jaebin401/TILT-mk.2/tools/servo_tool_UART/README.md

# TILT 서보 셋업 / 캘리브레이션 툴

`tilt_config.h` 의 TODO 항목을 실측으로 채우는 도구. 모든 결과는 **그대로 붙여넣을 수 있는 C 코드**로 출력된다.

다루는 관절은 `tilt_config.h` 의 8개: 다리당 Hip Roll / Hip Pitch / Knee Pitch / **Ankle Pitch**
(ID 11–14 = 왼다리, 21–24 = 오른다리). 배열 순서는 `LHR LHP LKP LAP | RHR RHP RKP RAP`.

| config 항목 | 채우는 툴 |
|---|---|
| `SERVO_ID[]` | `i` ID 변경 후 출력 안내에 맞춰 반영 |
| `ZERO_TICK[]` | 다리 6관절: `j` 정밀 조그 → `z` / 발목 2관절: `k` 발목 영점 → `j` 조그 → `n` |
| `JOINT_SIGN[]` | `s` 회전 부호 판별 |
| `JOINT_LIMIT[2][4]` | `l` 관절 제한 지정 (관절별 수동, Enter + y/n) |
| `SERVO_UART_BAUD` | `b` 보레이트 스캔 |

## 위치

```
TILT mk.2/
├── firmware/
│   └── components/
│       ├── tilt_config/
│       └── tilt_sts3215/
└── tools/
    └── servo_tool_UART/     ← 이 프로젝트
```

루트 `CMakeLists.txt` 의 `EXTRA_COMPONENT_DIRS` 가
`../../firmware/components` 를 가리키므로, 이 디렉토리에서 바로 빌드하면
공용 컴포넌트가 딸려 온다.

## 빌드

```bash
cd tools/servo_tool_UART
idf.py set-target esp32s3
idf.py -p /dev/tty.usbmodemXXXX flash monitor
```

`Ctrl + ]` 로 모니터 종료.

## tilt_sts3215 연결 방식

```cpp
tilt::sts3215::Sts3215Bus bus{config};
bus.initialize();
bus.ping(id);
bus.readPosition(id, tick);
bus.writePosition(id, tick, speed);
bus.setTorque(id, enabled);
bus.setBaudRate(baud);
```

`main.cpp` 상단의 얇은 래퍼가 기존 도구 호출을 이 실제 API로 연결한다.

## 저장 정책

**진실 공급원은 `tilt_config.h` 하나뿐이다.**

NVS 는 캘리브레이션 도중 리셋·정전으로 작업이 날아가지 않게 하는 임시 스크래치일 뿐이다.
부팅 시에는 **항상 config 값**을 쓴다. config 와 다른 스크래치가 있으면 그 사실만 알리고,
이어서 작업하려면 `r` 로 불러온다. (`h` / `u` 이동은 스크래치를 불러와도 항상 config 기준)

캘리브레이션이 끝나면:
1. 출력된 배열을 `tilt_config.h` 에 붙여넣고
2. `c` 로 NVS 스크래치를 비운다

이 두 단계를 하지 않으면 "코드에 적힌 값"과 "로봇이 실제로 쓰는 값"이 갈라진다.

## 영점 잡는 순서

1. **`i` ID 변경** — 서보를 반드시 한 개만 연결하고 목표 ID로 변경한 뒤 `SERVO_ID[]`에 반영
   - `p` ID 스캔이 끝에 config 의 8개 ID 중 응답 없는 것을 따로 알려준다
2. **`s` 부호 판별** — 먼저 해야 조그 화면의 DH theta 부호가 맞게 나온다 (발목 포함 8관절)
3. **`o` 엔코더 모니터** — 토크를 풀고 손으로 대략 다리 편 자세를 만든 뒤 `z` (다리 6관절만)
4. **`j` 정밀 조그** — FINE(1 tick = 0.088deg)로 마무리, DH theta 가 0.00 에 수렴하면 `z`
5. **`k` 발목 영점** — hip/knee 를 zero pose 로 세우고 발목만 토크를 푼 뒤, 몸통을 잡고 평평한 바닥에
   발바닥을 붙여 `z`. 발목은 그 위치에서 다시 토크 ON
6. **`j` 정밀 조그(발목)** — `u/j`(왼), `o/l`(오른)로 발바닥 평행을 마무리하고 `n`
7. 출력된 `ZERO_TICK` 을 `tilt_config.h` 에 붙여넣고 다시 빌드·플래시
8. **`h` HOME 이동** — config 영점으로 전 관절을 0° 로 이동, 다리가 곧게 펴졌는지 확인
9. **`u` zero pose 이동** — config 의 `[0, -20, +40, -20]` 으로 이동해 검증
   - 발판이 지면과 평행한가
   - 발바닥 점이 hip pitch 축 바로 아래(x≈0)인가
   - 지면 ~ hip pitch 축 높이가 약 137mm 인가 (`ZERO_POSE_HEIGHT_MM`)
10. **`l` 관절 제한 지정** — 마지막에. 영점이 확정돼야 각도 값이 의미를 가진다

`h` / `u` 는 pose_test 의 `h` / `s` 와 같은 방식이다: 8관절 위치를 모두 읽어 goal 로 기록 → 토크 ON →
rad 공간 smoothstep 보간을 10 ms 마다 sync write. 부팅 시 가속도 레지스터도 pose_test 처럼 0 으로 쓴다.
도착 후
도착 후 관절별 목표·실측·오차 표를 출력한다. 목표는 작업값이 아니라 **`tilt_config.h` 의 ZERO_TICK / JOINT_SIGN** 으로 계산한다.

## 관절 제한 지정 (`l`)

관절 하나씩 순서대로 (LHR → LHP → LKP → LAP → RHR → … → RAP):

1. 최소(−)쪽 끝까지 움직인다 — `+` / `-` 키(스텝 `m`: 1° → 5° → 0.2°), 또는 `f` 로 그 관절만 토크를 풀고 손으로
2. `Enter` → `y/n` 으로 그 각도(서보 실측)를 최소 한계로 확정
3. 최대(+)쪽도 같은 방식으로 확정
4. 그 관절은 0° 로 돌아가고 다음 관절로 넘어간다

| 키 | 기능 |
|---|---|
| `+` / `-` | 이 관절을 DH +/- 방향으로 한 스텝 |
| `m` | 스텝 1° → 5° → 0.2° |
| `f` | 이 관절만 토크 OFF/ON |
| `Enter` | 지금 각도를 확정 (y/n) |
| `>` / `<` | 이 쪽은 기존 값 유지하고 다음 / 이전 관절로 |
| `x` | 종료하고 `JOINT_LIMIT` 출력 |

확정하지 않은 쪽은 config 값을 그대로 유지하며, 출력 주석에 `실측` / `기존` 으로 표시된다.
최소가 0° 보다 크거나 최대가 0° 보다 작으면 부호 문제일 수 있어 경고를 띄운다.

## 서보 ID 변경

`i`를 누르면 현재 ID와 새 ID를 입력받아 STS3215 EEPROM의 ID를 변경한다.

1. 외부 서보 전원을 끈다.
2. 변경할 STS3215 **한 개만** UART 버스에 연결한다.
3. 전원을 켜고 `p`로 현재 ID를 확인한다.
4. `i`를 누르고 현재 ID와 사용하지 않은 새 ID를 입력한다.
5. 성공 메시지를 확인한 뒤 서보와 케이블에 새 ID를 표시한다.
6. `tilt_config.h`의 `SERVO_ID[]`도 같은 값으로 수정한다.

툴은 새 ID가 이미 응답하면 변경을 거부한다. 변경 시 토크를 끄고 EEPROM 잠금을
해제한 뒤 ID를 기록하며, 새 ID로 EEPROM을 다시 잠그고 이전/새 ID 응답까지 검증한다.
같은 현재 ID를 가진 서보가 여러 개 연결돼 있으면 모두 함께 바뀔 수 있으므로 단일 연결
규칙을 반드시 지켜야 한다.

### 각 관절의 DH theta = 0 자세

| 관절 | 영점 자세 |
|---|---|
| Hip Roll | 다리가 좌우로 기울지 않고 수직 |
| Hip Pitch | 허벅지가 수직 |
| Knee Pitch | 정강이가 허벅지와 일직선 |
| Ankle Pitch | 발바닥이 정강이와 직각 (다리를 편 HOME 에서 발바닥이 바닥과 평행) |

`zero pose` 인 `[0, -20, +40, -20]` 과 혼동하지 말 것. 영점은 **DH theta = 0** 인 자세(다리를 쭉 펴고 발바닥 평행)이고,
zero pose 는 거기서 허벅지를 20° 앞으로, 정강이를 20° 뒤로 기울이고(무릎 +40°) 발목 −20° 로 발바닥을 지면과
평행하게 맞춘 **운용 기본자세**다. 발바닥 평행 조건은 `hip + knee + ankle = 0`.
`k` 발목 영점은 zero pose 에서 발바닥을 바닥에 붙여 잡으므로 이 정의와 맞는다 (ankle = `ZERO_POSE_RAD` 의 −20° 로 역산).

### DH + 방향

| 관절 | + 방향 |
|---|---|
| Hip Roll | 발이 로봇의 왼쪽(+y)으로 (왼다리=벌림, 오른다리=모음) |
| Hip Pitch | 다리가 뒤로 스윙 |
| Knee Pitch | 무릎이 굽음 |
| Ankle Pitch | 발끝이 내려감 (toes down) |

좌우 다리 모두 같은 정의를 쓴다(로봇 시선 기준 오른손 회전 규칙). 거울 반전은 `JOINT_SIGN` 이 흡수한다.

## 안전

- 서보 전원은 손 닿는 곳에 두고, 언제든 끌 수 있게 한다
- `space` = 전체 토크 OFF (어느 화면에서든)
- 부팅 시 절대 위치 명령을 보내지 않는다 — 현재 위치를 READ 해서 goal 로 먼저 기록한 뒤 토크를 켠다
- 토크를 켜는 모든 경로(`j`, `s`, `0`, `t`, 부팅)는 같은 순서를 따른다. 위치 읽기가 실패하면 토크를 켜지 않는다
- `s` 부호 판별과 `h` / `u` 이동, `l` 관절 제한 지정은 **공중에 매단 상태**에서 할 것
- `0` 은 영점(`ZERO_TICK`)을 확정한 뒤에만 실행할 것. placeholder(2048) 상태에서는 엉뚱한 자세로 움직인다
- `l` 관절 제한은 다리끼리 부딪히기 직전까지만. 키로 밀다가 서보가 걸려 버티면 바로 반대 키로 물러날 것. 특히 Hip Roll 안쪽(모음) 방향은 다리끼리 충돌하기 쉽다
- `k` 는 발목 토크를 푼다 — 로봇이 발목으로 서 있지 못하니 몸통을 반드시 잡고 할 것
- NVS 스크래치 키가 8관절 형식(`zero_tick8`, `joint_sign8`)으로 바뀌어, 이전 6관절 스크래치는 읽지 않는다

## 툴 목록

| 키 | 기능 |
|---|---|
| `p` | ID 스캔 (0~253) + config 8개 ID 응답 확인 |
| `i` | 서보 ID 변경 (한 번에 한 개만 연결, EEPROM 재잠금·응답 검증) |
| `b` | 보레이트 스캔 |
| `j` | 정밀 조그 (q/a w/s e/d u/j = 왼쪽 ROLL/PITCH/KNEE/ANKLE, r/f t/g y/h o/l = 오른쪽, `m` 스텝 토글, `i` 상태표, `z` 다리 영점, `n` 발목 영점) |
| `o` | 토크 해제 + 엔코더 실시간 모니터 (`z` 다리 영점, `n` 발목 영점) |
| `k` | 발목 영점: zero pose 로 세우고 발목만 토크 OFF → 발바닥을 바닥에 붙여 `z` |
| `l` | 관절 제한 지정 (관절별 수동, Enter + y/n) → `JOINT_LIMIT` 출력 |
| `s` | 회전 부호 판별 → `JOINT_SIGN` 출력 |
| `h` (또는 `0`) | HOME — 전 관절 0° 로 이동 (pose_test `h` 와 같은 방식, config 기준, 2초 + 오차표) |
| `u` | STAND — zero pose [0, -20, +40, -20] 으로 이동 (config 기준, 2초 + 오차표) |
| `v` | 현재 작업값 배열 전부 출력 (영점·부호·제한) |
| `r` | NVS 스크래치를 작업값으로 불러오기 |
| `c` | NVS 스크래치 비우기 |
| `t` | 전체 토크 ON/OFF 토글 |
| `?` | 메뉴 |
| `space` | 비상정지 |
