jaebin401/TILT-mk.2/model/meshes/assembly_1_collision.stl

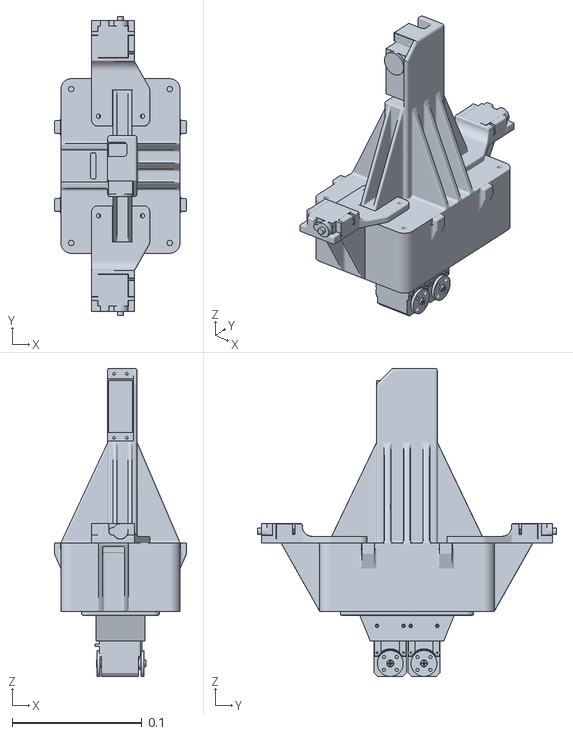
[picture p1: CAD file, 2026-10-07]
model/meshes/assembly_1_collision.stl
0.102 x 0.231 x 0.238
