jaebin401/TILT-mk.2/model/meshes/arm_r_assembly_visual.stl

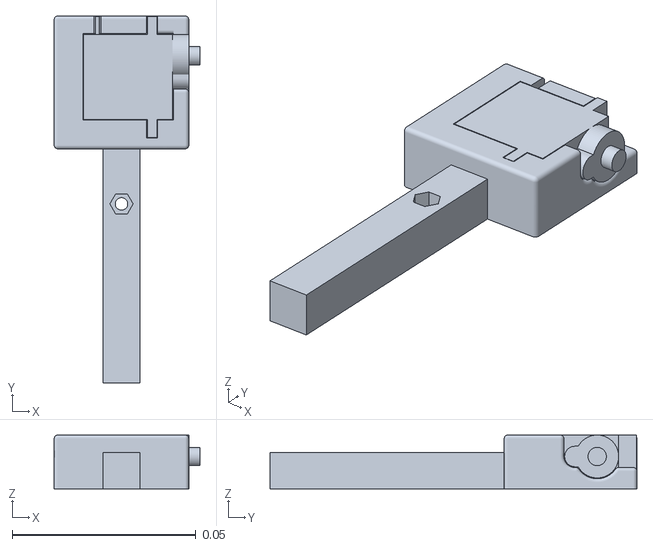
[picture p2: CAD file, 2026-10-07]
model/meshes/arm_r_assembly_visual.stl
0.0397 x 0.1 x 0.0147
