jaebin401/TILT-mk.2/model/meshes/assembly_1_2_visual.stl

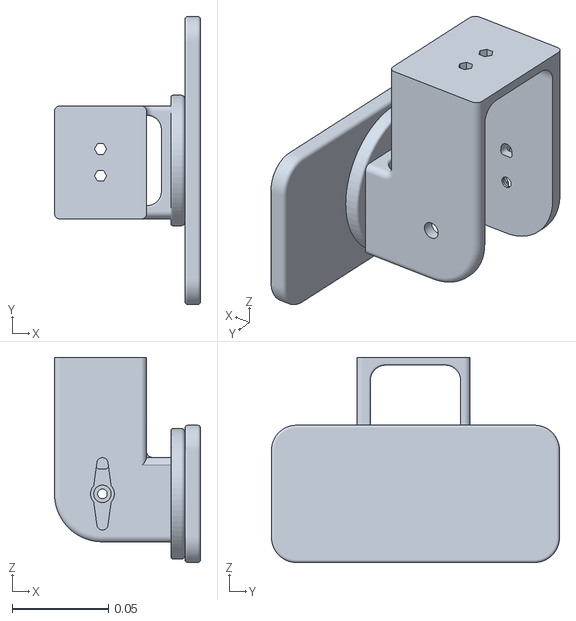
[picture p3: CAD file, 2026-10-07]
model/meshes/assembly_1_2_visual.stl
0.0761 x 0.15 x 0.107
