jaebin401/TILT-mk.2/CAD/TILT mk.2 step files/arm/arm R v2.step

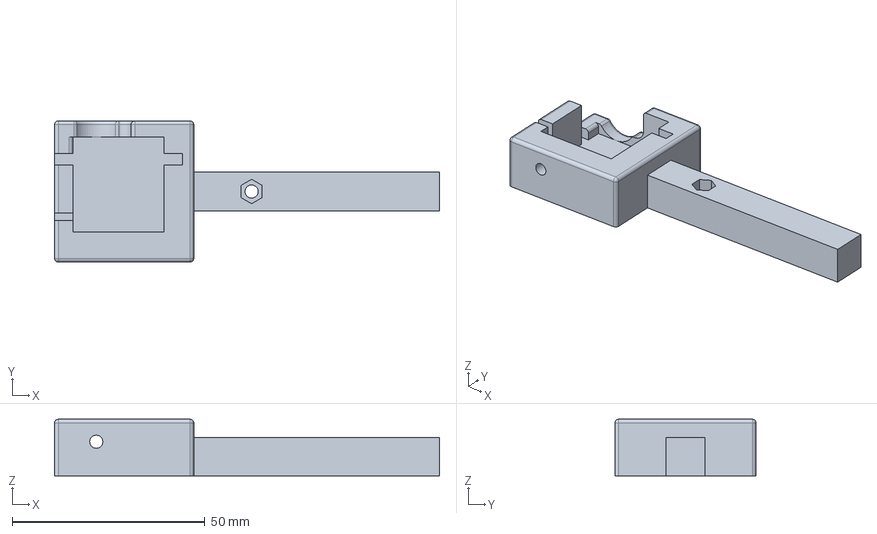
[picture p4: CAD file, 2026-10-07]
CAD/TILT mk.2 step files/arm/arm R v2.step
100.0 x 36.7 x 14.7 mm
