jaebin401/TILT-mk.2/CAD/TILT mk.2 step files/head/ear.step

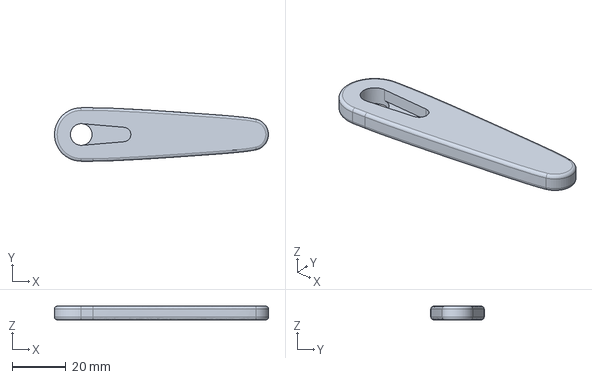
[picture p5: CAD file, 2026-10-07]
CAD/TILT mk.2 step files/head/ear.step
80.0 x 20.0 x 5.10 mm
