jaebin401/TILT-mk.2/CAD/TILT mk.2 step files/leg/hip pitch mount.step

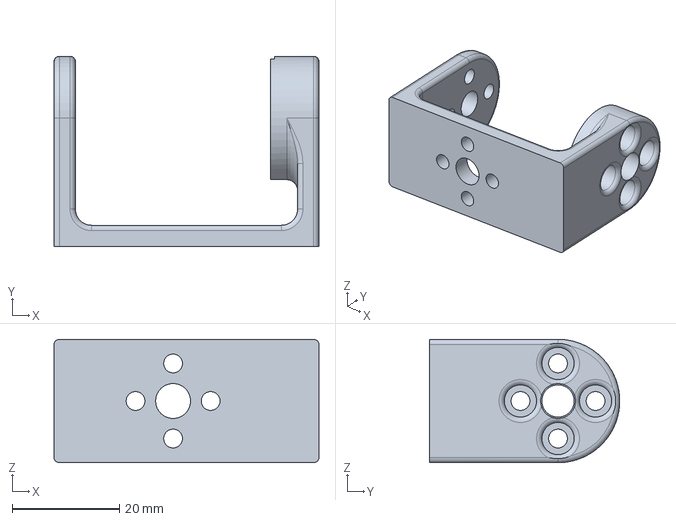
[picture p6: CAD file, 2026-10-07]
CAD/TILT mk.2 step files/leg/hip pitch mount.step
49.4 x 35.5 x 23.0 mm
