jaebin401/TILT-mk.2/CAD/TILT mk.2 step files/torso/torso v2.step

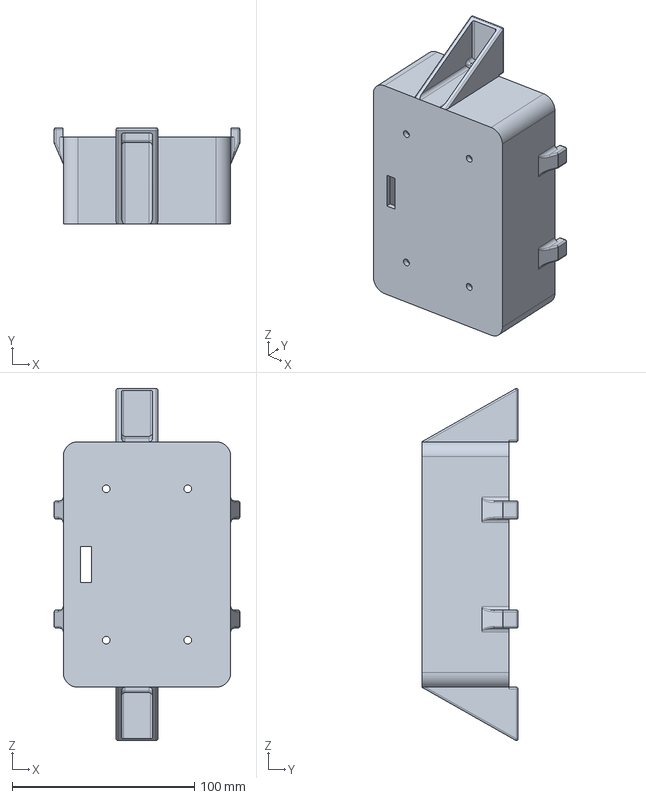
[picture p7: CAD file, 2026-10-07]
CAD/TILT mk.2 step files/torso/torso v2.step
102.0 x 53.0 x 193.4 mm
