jaebin401/TILT-mk.2/CAD/TILT mk.2 step files/arm/our sg90.step

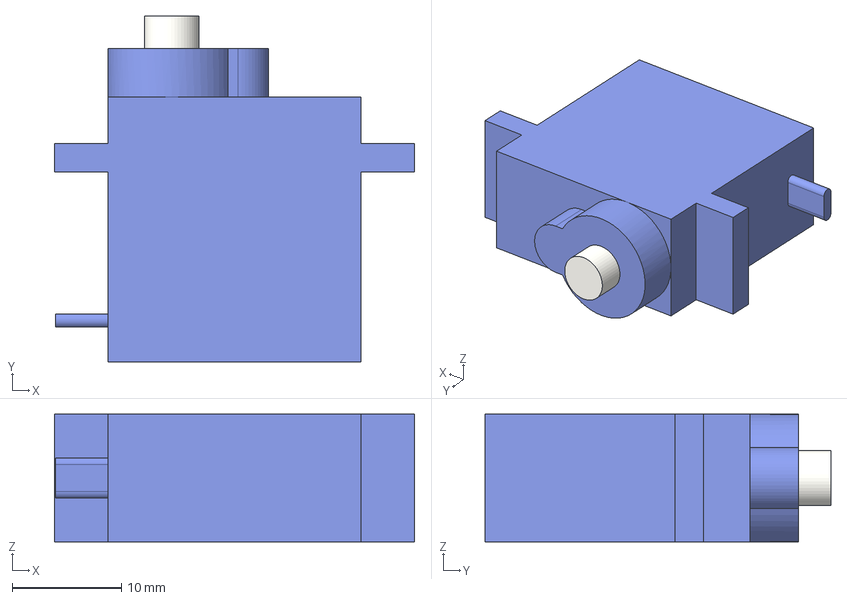
[picture p8: CAD file, 2026-10-07]
CAD/TILT mk.2 step files/arm/our sg90.step
33.0 x 31.7 x 11.7 mm
