jaebin401/TILT-mk.2/CAD/TILT mk.2 step files/head/iPhone 17.step

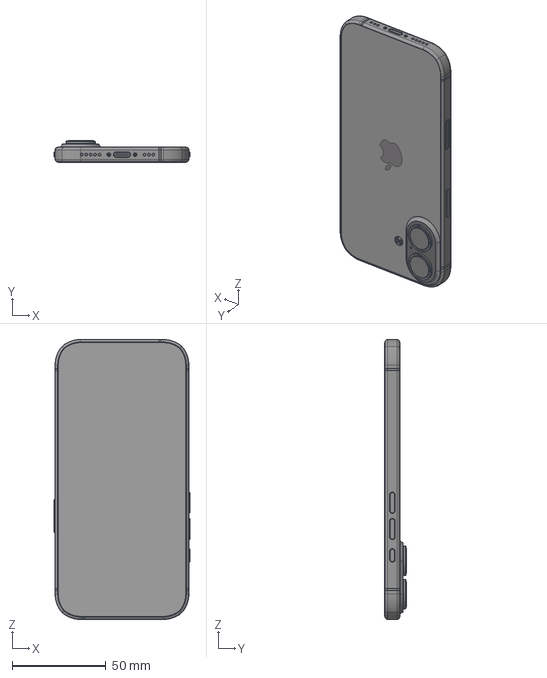
[picture p9: CAD file, 2026-10-07]
CAD/TILT mk.2 step files/head/iPhone 17.step
72.5 x 11.5 x 149.6 mm
