jaebin401/TILT-mk.2/CAD/TILT mk.2 step files/leg/foot.step

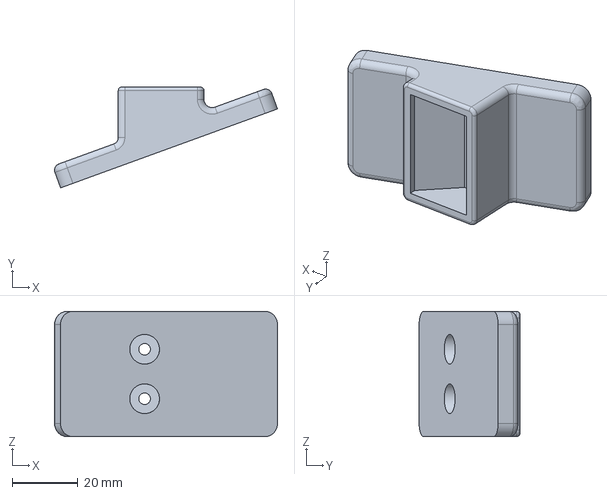
[picture p10: CAD file, 2026-10-07]
CAD/TILT mk.2 step files/leg/foot.step
67.6 x 30.5 x 38.0 mm
