jaebin401/TILT-mk.2/CAD/TILT mk.2 step files/torso/torso lid v.2.step

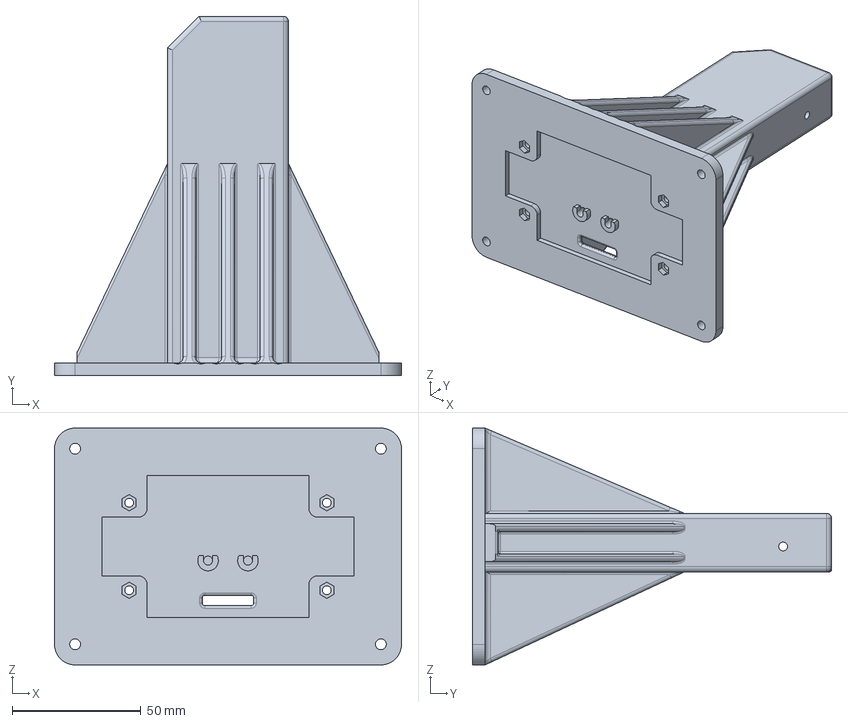
[picture p11: CAD file, 2026-10-07]
CAD/TILT mk.2 step files/torso/torso lid v.2.step
134.8 x 139.7 x 92.0 mm
