jaebin401/TILT-mk.2/CAD/TILT mk.2 step files/arm/shoulder v2.step

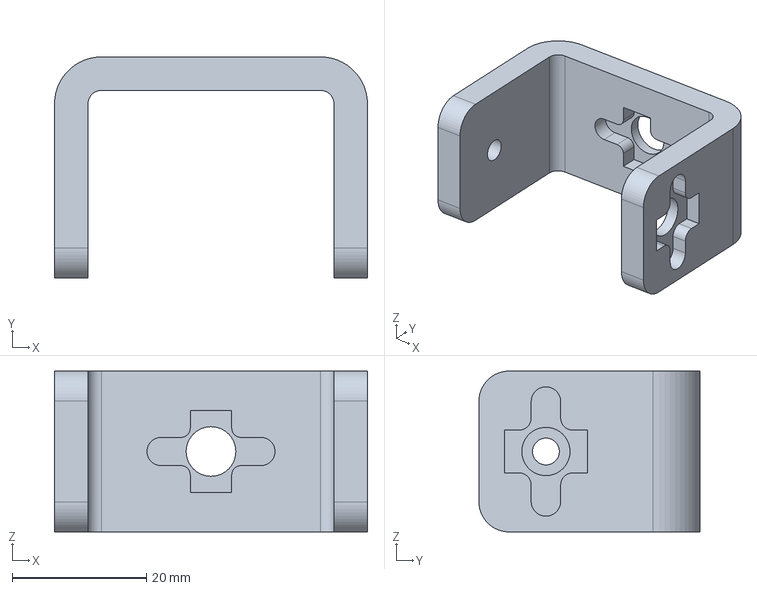
[picture p12: CAD file, 2026-10-07]
CAD/TILT mk.2 step files/arm/shoulder v2.step
46.7 x 33.0 x 24.0 mm
