jaebin401/TILT-mk.2/CAD/TILT mk.2 step files/head/magsafe mount.step

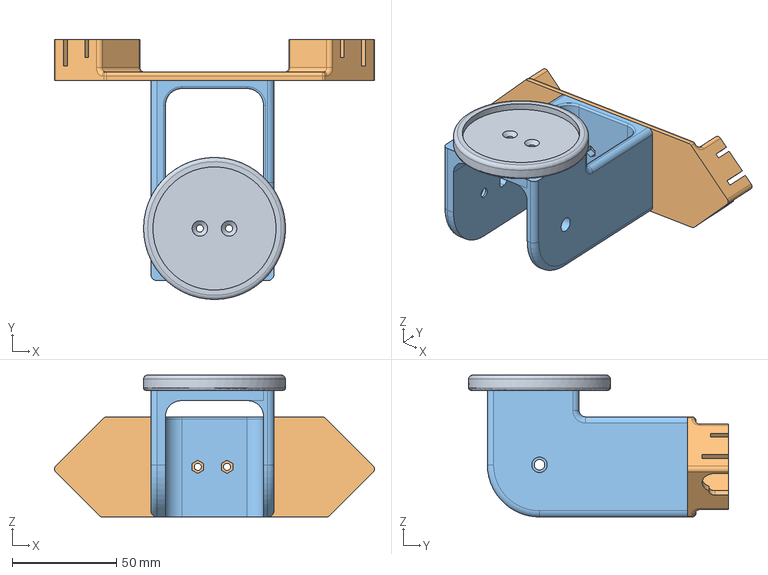
[picture p13: CAD file, 2026-10-07]
CAD/TILT mk.2 step files/head/magsafe mount.step
153.3 x 124.5 x 68.0 mm
