jaebin401/TILT-mk.2/CAD/TILT mk.2 step files/leg/thigh.step

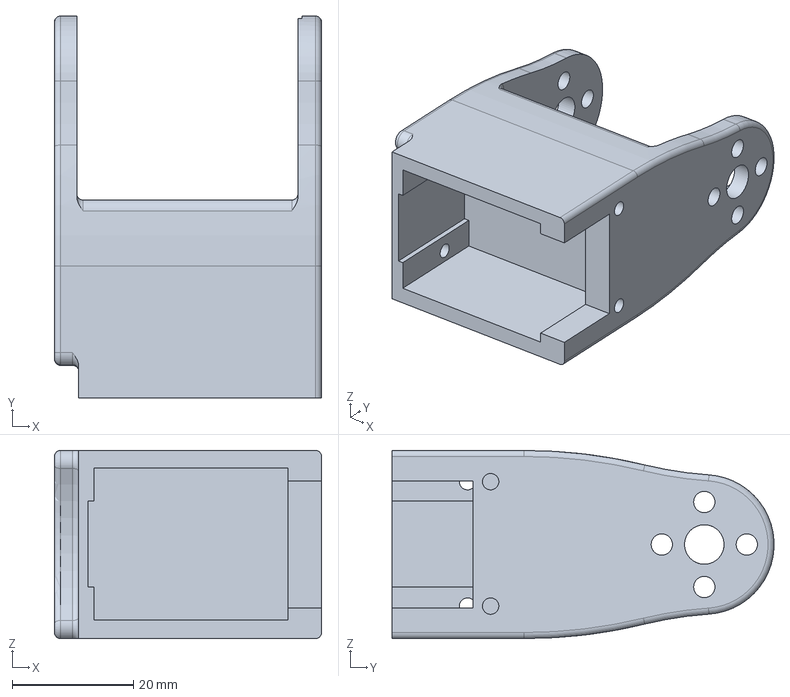
[picture p14: CAD file, 2026-10-07]
CAD/TILT mk.2 step files/leg/thigh.step
44.0 x 62.9 x 31.0 mm
