jaebin401/TILT-mk.2/CAD/TILT mk.2 step files/torso/MG996R.step

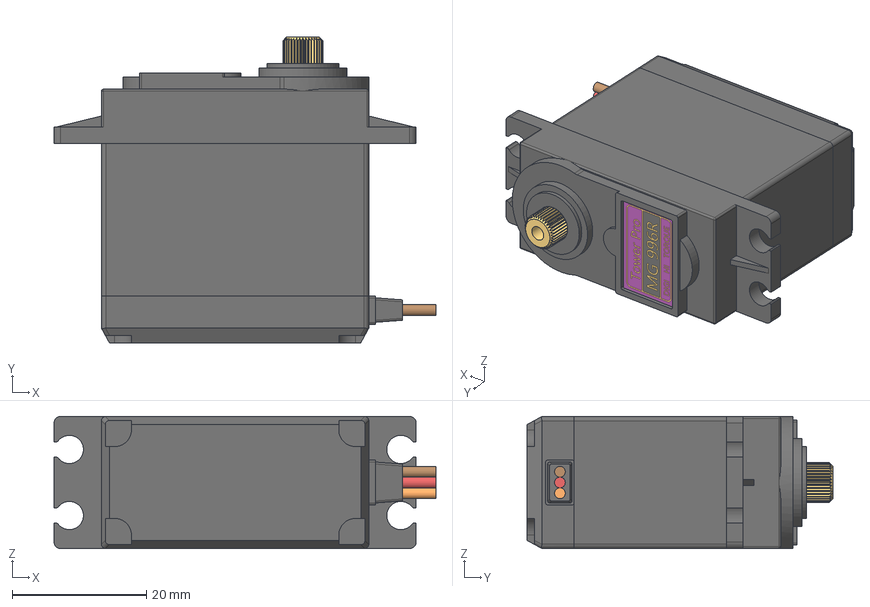
[picture p15: CAD file, 2026-10-07]
CAD/TILT mk.2 step files/torso/MG996R.step
57.0 x 45.5 x 19.7 mm
servoMotorMG996R
servoMotorMG996R (1)
servoMotorMG996R (2)
servoMotorMG996R (3)
servoMotorMG996R (4)
servoMotorMG996R (5)
servoMotorMG996R (6)
servoMotorMG996R (7)
attachmentCircular
attachmentCircular (1)
attachmentCross
attachmentStar
attachmentStraight
