jaebin401/TILT-mk.2/CAD/TILT mk.2 step files/arm/arm mount R v2.step

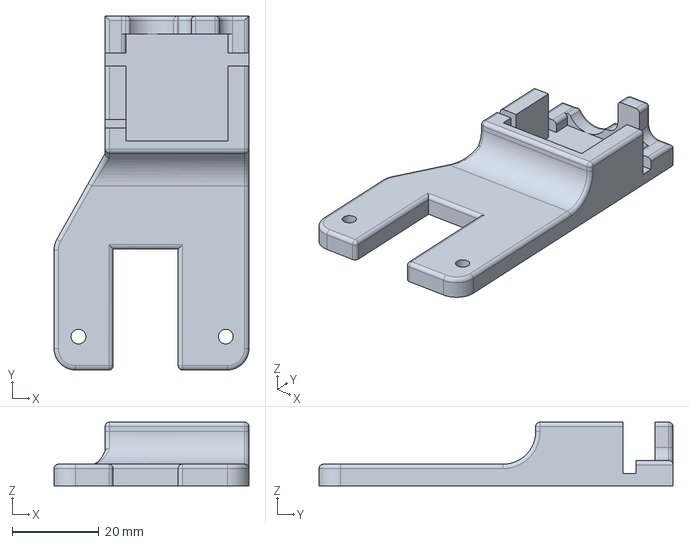
[picture p16: CAD file, 2026-10-07]
CAD/TILT mk.2 step files/arm/arm mount R v2.step
45.0 x 81.7 x 14.7 mm
