jaebin401/TILT-mk.2/CAD/TILT mk.2 step files/leg/calf L.step

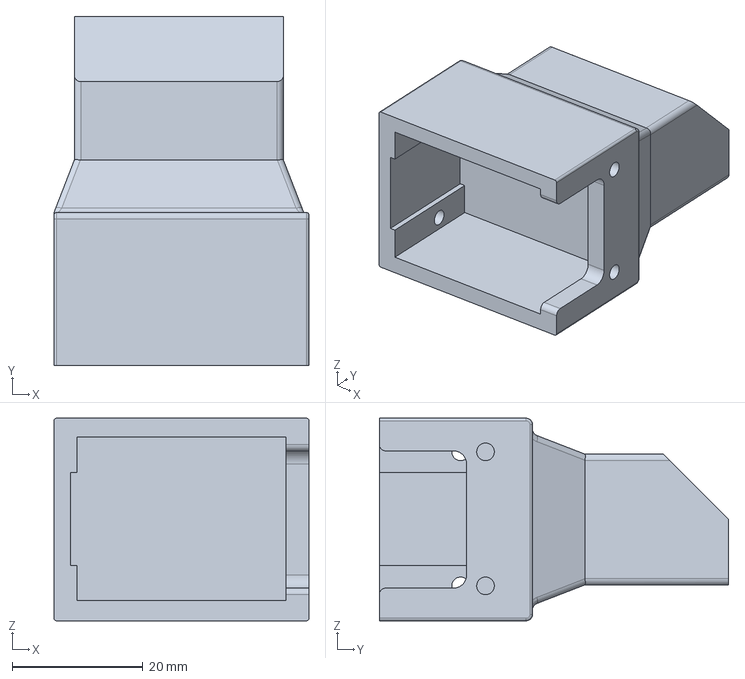
[picture p17: CAD file, 2026-10-07]
CAD/TILT mk.2 step files/leg/calf L.step
39.0 x 53.4 x 31.0 mm
