jaebin401/TILT-mk.2/CAD/TILT mk.2 step files/leg/hip roll mount.step

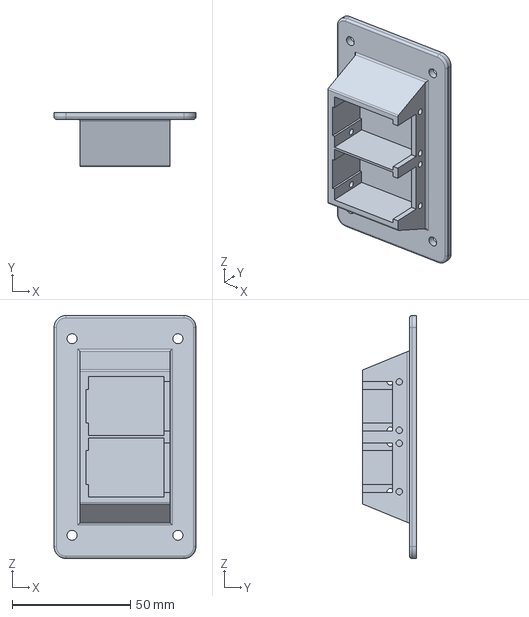
[picture p18: CAD file, 2026-10-07]
CAD/TILT mk.2 step files/leg/hip roll mount.step
60.0 x 23.0 x 102.8 mm
