jaebin401/TILT-mk.2/model/meshes/calf_r_collision.stl

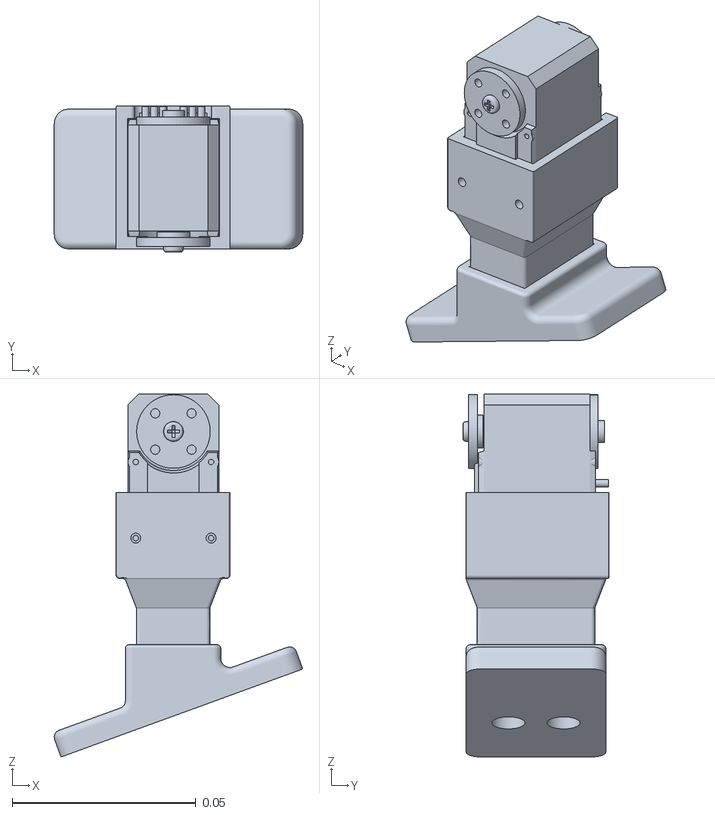
[picture p19: CAD file, 2026-10-07]
model/meshes/calf_r_collision.stl
0.0676 x 0.0398 x 0.0987
