jaebin401/TILT-mk.2/CAD/TILT mk.2 step files/leg/STS3215.step

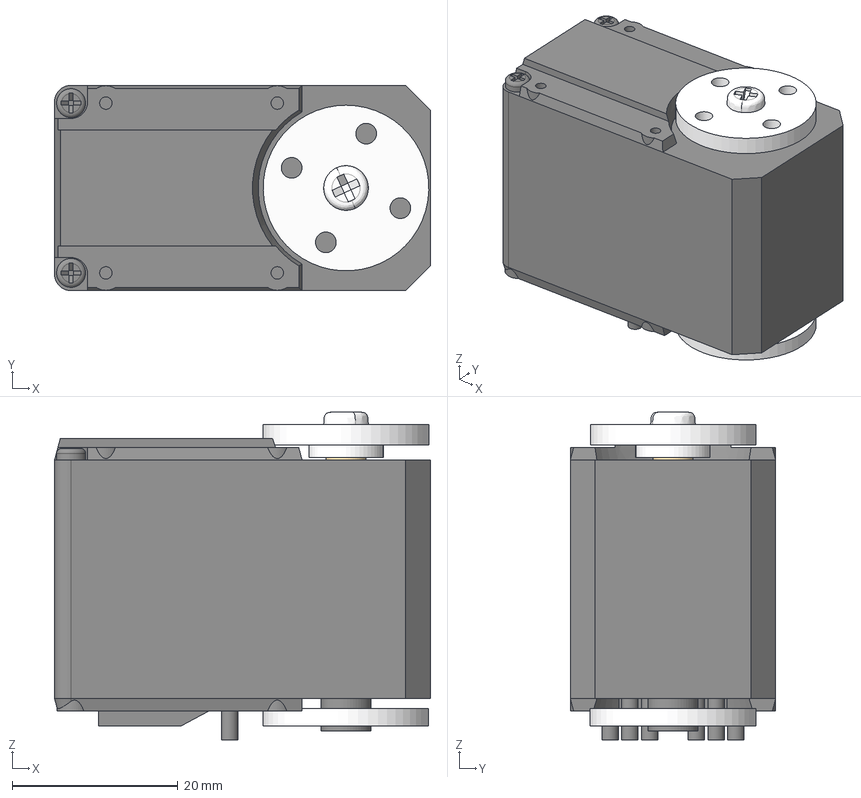
[picture p20: CAD file, 2026-10-07]
CAD/TILT mk.2 step files/leg/STS3215.step
45.4 x 24.8 x 39.6 mm
ac2
ac1
main
