jaebin401/TILT-mk.2/model/meshes/thigh_2_visual.stl

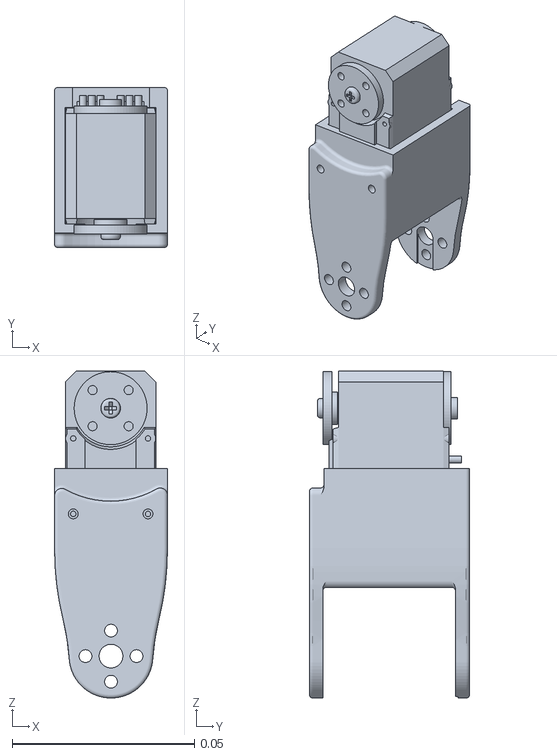
[picture p21: CAD file, 2026-10-07]
model/meshes/thigh_2_visual.stl
0.031 x 0.044 x 0.0897
