jaebin401/TILT-mk.2/model/meshes/hip_pitch_mount_2_collision.stl

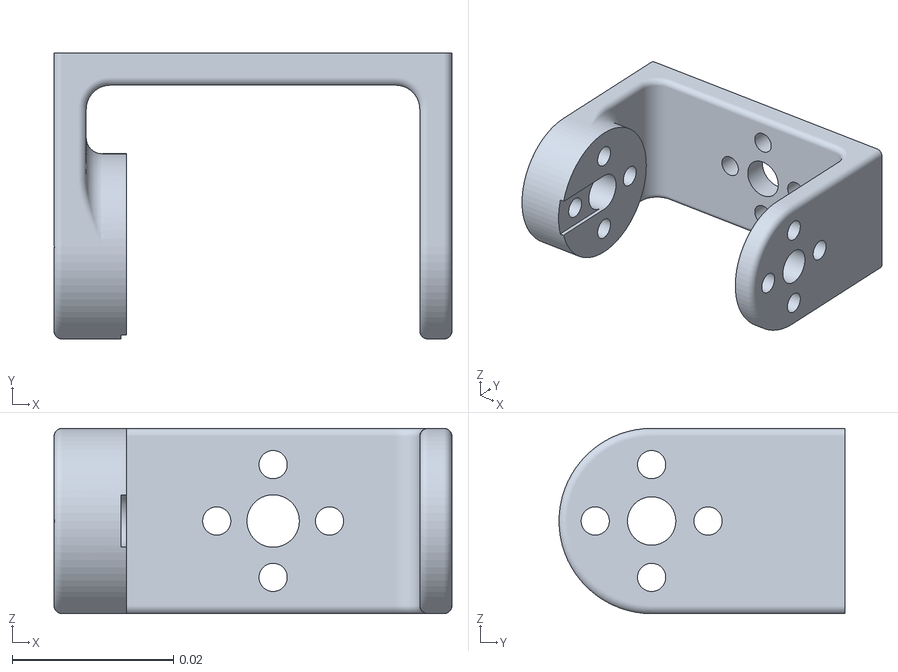
[picture p22: CAD file, 2026-10-07]
model/meshes/hip_pitch_mount_2_collision.stl
0.0494 x 0.0355 x 0.023
