jaebin401/TILT-mk.2/model/meshes/shoulder_visual.stl

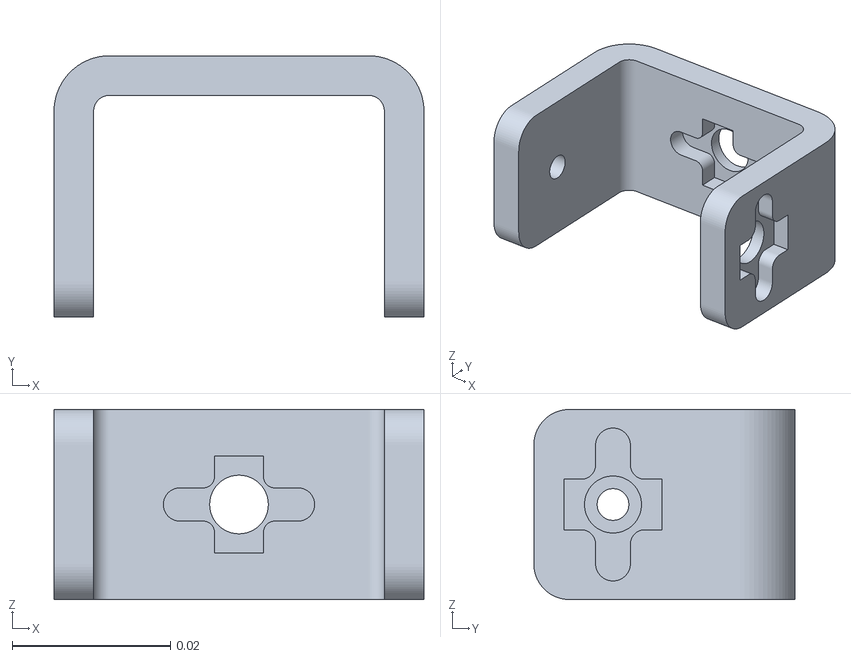
[picture p23: CAD file, 2026-10-07]
model/meshes/shoulder_visual.stl
0.0467 x 0.033 x 0.024
