jaebin401/TILT-mk.2/(list of files, cad)

Other CAD files:
model/meshes/arm_l_assembly_visual.stl
model/meshes/arm_l_assembly_collision.stl
model/meshes/thigh_collision.stl
model/meshes/hip_pitch_mount_visual.stl
model/meshes/thigh_visual.stl
model/meshes/calf_l_collision.stl
model/meshes/shoulder_2_visual.stl
model/meshes/calf_l_visual.stl
model/meshes/shoulder_2_collision.stl
model/meshes/hip_pitch_mount_collision.stl
