jaebin401/TILT-mk.2/simulation/results/rocking_search.csv

support | roll_deg | roll_time | lift_deg | lift_time | lift_offset | hold_time | return_time | success | ssp_duration_s | max_swing_clearance_mm | max_stance_slip_mm | peak_torque_nm | peak_torque_ratio | peak_speed_rad_s | peak_current_a | peak_total_leg_current_a | longest_over_rated_s | longest_over_2a_s | min_capture_margin_mm | max_torso_roll_deg | max_torso_pitch_deg | nonfoot_floor_contact | fell | score
right | 12.0 | 0.15 | 15.0 | 0.2 | 0.0 | 0.08 | 0.3 | True | 0.21800000000000017 | 5.767115205180903 | 4.757194308853207 | 1.91229675 | 1.0 | 2.524994297580742 | 2.4375 | 5.205964270015538 | 1.382000000000001 | 0.8200000000000006 | -54.70273868652774 | 5.553775646213799 | 2.428292305211408 | False | False | 87.97122276458725
left | 11.0 | 0.15 | 15.0 | 0.2 | -0.05 | 0.08 | 0.3 | True | 0.17600000000000013 | 4.693601542077569 | 3.811920104615546 | 1.91229675 | 1.0 | 2.53753271276776 | 2.4375 | 5.198502269821162 | 1.332000000000001 | 0.7600000000000006 | -53.70161814149598 | 4.948207791850839 | 2.2725757385281864 | False | False | 70.13952266569302
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
