jaebin401/TILT-mk.2/firmware/tests/dcm_rocking_test/results/2026-10-08_floor_compare.png

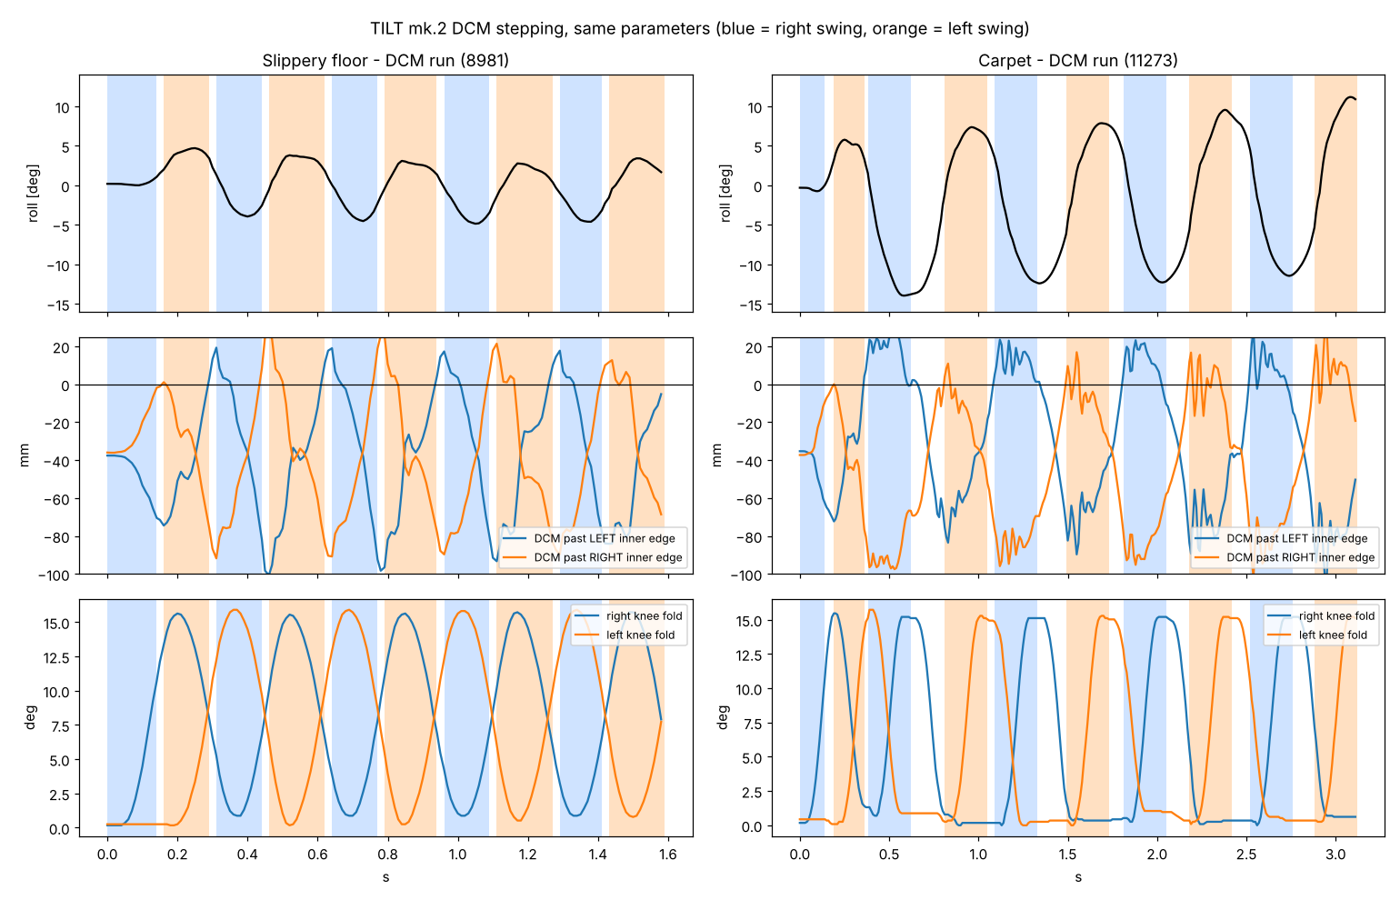
firmware/tests/dcm_rocking_test/results/2026-10-08_floor_compare.png
