jaebin401/TILT-mk.2/simulation/results/rocking_conservative_3cycles.png

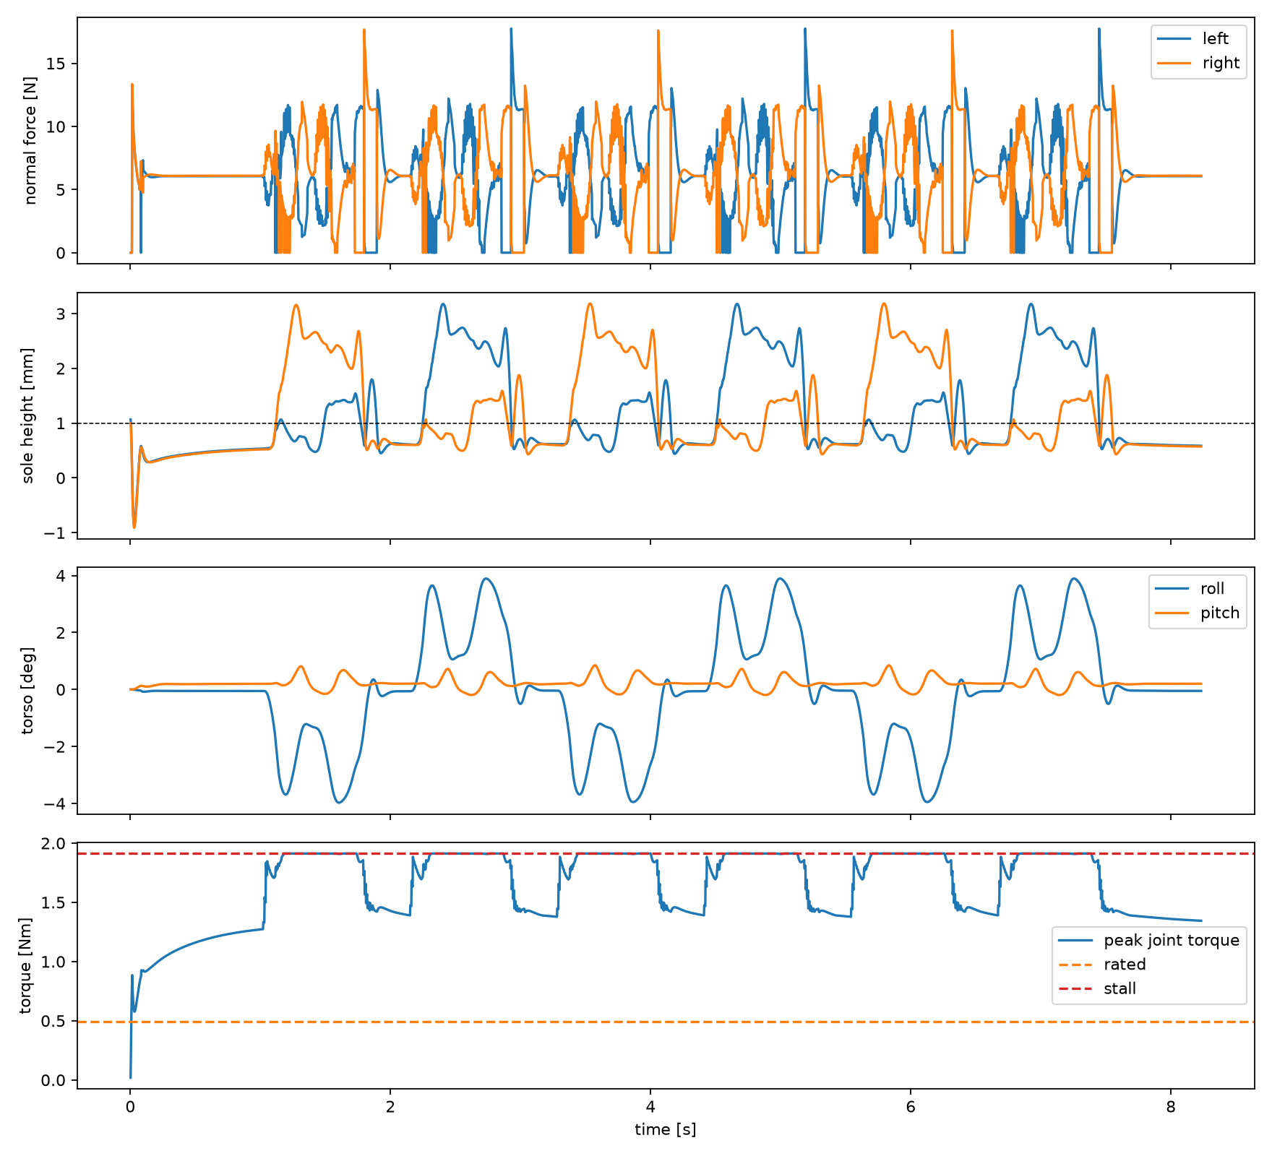
simulation/results/rocking_conservative_3cycles.png
