jaebin401/TILT-mk.2/(commit log)

2026-10-06 chore(firmware): adapt joint config to mk2 hip roll
2026-10-06 chore(firmware): prepare kinematics and servo tool for mk2 calibration
2026-10-06 fix(tools): hold current position before enabling servo torque
    [main.cpp]
2026-10-06 feat(tools): add servo id setting feature in servo setup UART
2026-10-06 fix(firmware): modify motor joint config
2026-10-07 chore(CAD): add step files
    [MG996R.step, STS3215.step, arm R v2.step, arm mount R v2.step, calf L.step, ear.step, foot.step, hip pitch mount.step]
2026-10-07 feat(model): add simulation files
    [arm_l_assembly_collision.stl, arm_l_assembly_visual.stl, arm_r_assembly_collision.stl, arm_r_assembly_visual.stl, assembly_1_2_collision.stl, assembly_1_2_visual.stl, assembly_1_collision.stl, assembly_1_visual.stl]
2026-10-07 feat(simulation): add MuJoCo environment settings and initial gait test
    [robot.xml, rocking_search.csv, scene.xml]
2026-10-08 fix(firmware): modify print style on terminal
    [main.cpp]
2026-10-08 feat(firmware): add kinematics components for mk.2
2026-10-08 feat(firmware): add PWM servo basic tool codes
2026-10-09 fix(firmware): recalibratte zero position and joint limit
2026-10-09 feat(firmware): add joint control for stand pose
2026-10-13 feat(tools): add ankle pitch axis and upadate
2026-10-14 fix(tools): harden eight-joint calibration workflow
2026-10-14 feat(firmware): migrate leg stack to 8-DOF ankle pitch
2026-10-14 fix(firmware): fix R ankle pitch direction error
2026-10-21 feat(firmware): add TB6612FNG driver components and wheel base draft codes
